Igorek3xd/-Sky-/3_Plata_fabrichna/Spisok_komponentov_BOM.csv

Reference | Value | Footprint | QUANTITY
C1,C2 | 4.7uF | Capacitor_SMD:C_0805_2012Metric | 2
C3,C4 | 10uF | Capacitor_SMD:C_0805_2012Metric | 2
C5,C8,C10 | 100nF | Capacitor_SMD:C_0603_1608Metric | 3
C6,C7 | 1uF | Capacitor_SMD:C_0603_1608Metric | 2
C9 | 10nF | Capacitor_SMD:C_0603_1608Metric | 1
D1 | SS14 | Diode_SMD:D_SMA | 1
D2 | CHG red | LED_SMD:LED_0603_1608Metric | 1
F1 | 500mA PTC | Fuse:Fuse_1206_3216Metric | 1
J1 | USB-C | Connector_USB:USB_C_Receptacle_HRO_TYPE-C-31-M-12 | 1
J2 | LiPo 1S 1000mAh | Connector_JST:JST_PH_S2B-PH-SM4-TB_1x02-1MP_P2.00mm_Horizontal | 1
J3 | OLED 0.96 SSD1306 | Connector_PinHeader_2.54mm:PinHeader_1x04_P2.54mm_Vertical | 1
Q1,Q2 | AO3401A | Package_TO_SOT_SMD:SOT-23 | 2
R1,R2 | 5.1k | Resistor_SMD:R_0603_1608Metric | 2
R3 | 4.7k (210mA) | Resistor_SMD:R_0603_1608Metric | 1
R4 | 1k | Resistor_SMD:R_0603_1608Metric | 1
R5,R10,R13,R16,R17 | 100k | Resistor_SMD:R_0603_1608Metric | 5
R6-R9 | 10k | Resistor_SMD:R_0603_1608Metric | 4
R11,R12 | 4.7k | Resistor_SMD:R_0603_1608Metric | 2
R14,R15 | 1M | Resistor_SMD:R_0603_1608Metric | 2
SW1 | WAKE (side) | Button_Switch_SMD:SW_SPST_EVQP7A | 1
SW2 | RESET | Button_Switch_SMD:SW_Push_SPST_NO_Alps_SKRK | 1
SW3 | BOOT | Button_Switch_SMD:SW_Push_SPST_NO_Alps_SKRK | 1
U1 | USBLC6-2SC6 | Package_TO_SOT_SMD:SOT-23-6 | 1
U2 | MCP73831-2-OT | Package_TO_SOT_SMD:SOT-23-5 | 1
U3 | ME6211C33M5 | Package_TO_SOT_SMD:SOT-23-5 | 1
U4 | ESP32-C3-WROOM-02 | RF_Module:ESP32-C3-WROOM-02 | 1
U5 | SHT40 | Sensor_Humidity:Sensirion_DFN-4_1.5x1.5mm_P0.8mm_SHT4x_NoCentralPad | 1
