Igorek3xd/-Sky-/1_Korpus_3D/ThermoBox_case_assembly.step

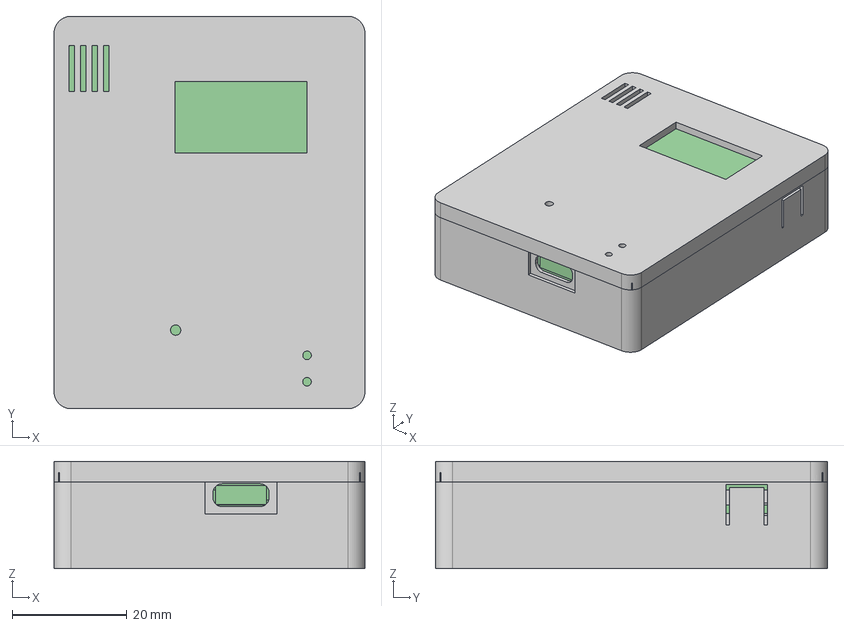
[picture p12: CAD file, 2026-11-13]
1_Korpus_3D/ThermoBox_case_assembly.step
54.2 x 68.4 x 18.7 mm
