Igorek3xd/-Sky-/1_Korpus_3D/ThermoBox_Base.stl

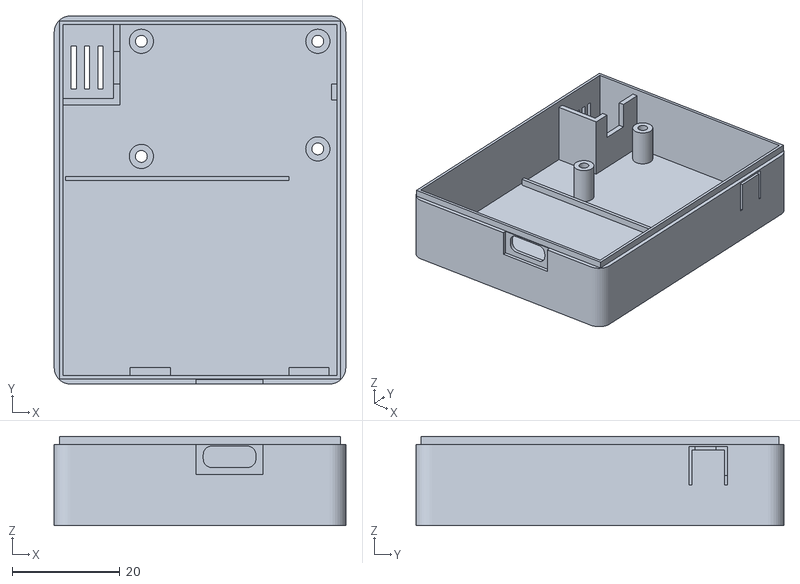
[picture p13: CAD file, 2026-11-13]
1_Korpus_3D/ThermoBox_Base.stl
54.2 x 68.4 x 16.6
