Igorek3xd/-Sky-/1_Korpus_3D/ThermoBox_Lid.stl

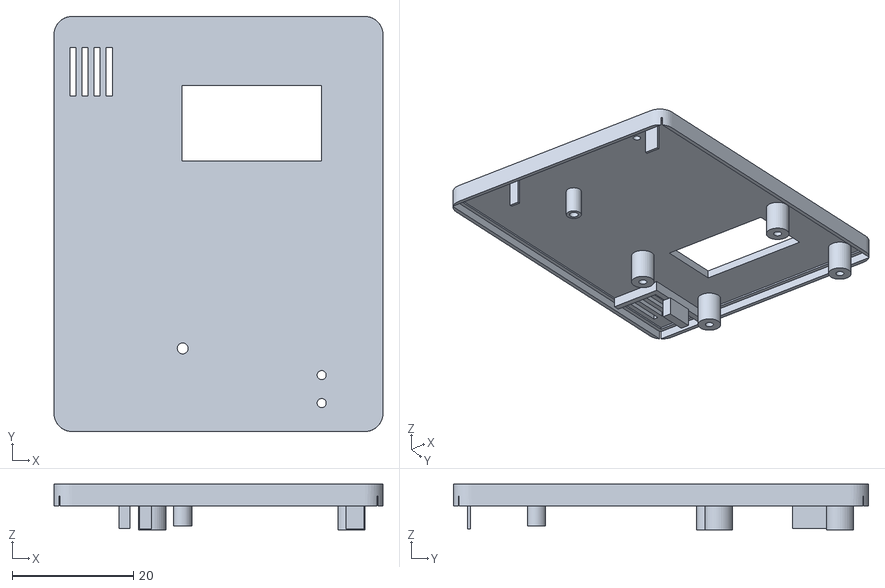
[picture p14: CAD file, 2026-11-13]
1_Korpus_3D/ThermoBox_Lid.stl
54.2 x 68.4 x 7.50
