Igorek3xd/-Sky-/1_Korpus_3D/ThermoBox_plata.step

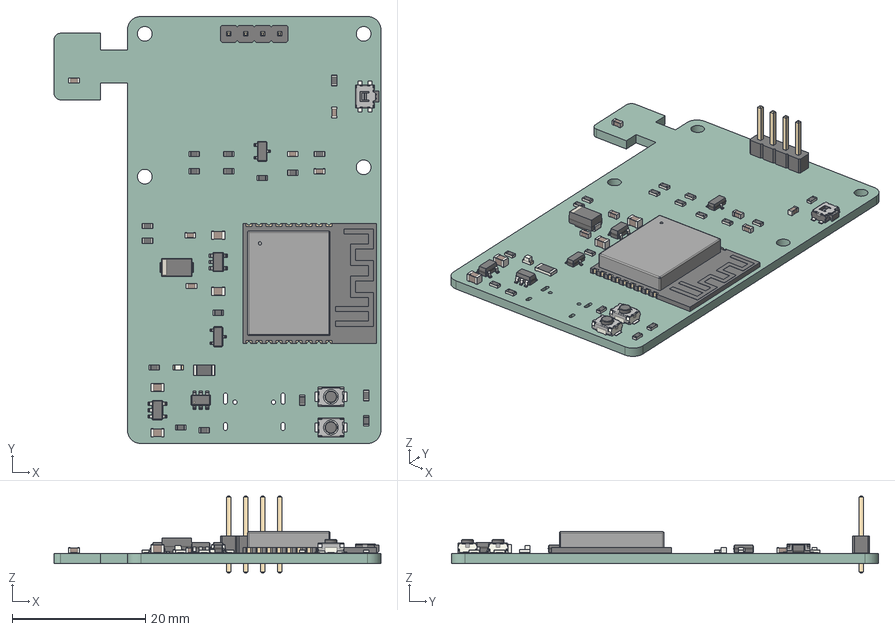
[picture p15: CAD file, 2026-11-13]
1_Korpus_3D/ThermoBox_plata.step
49.0 x 64.0 x 11.5 mm
R_0603_1608Metric x 17
C_0805_2012Metric x 4
C_0603_1608Metric x 6
PinHeader_1x04_P254mm_Vertical
SOT-23-6
SOT-23-5 x 2
Fuse_1206_3216Metric
D_SMA
LED_0603_1608Metric
ESP32-C3-WROOM-02
SW_Push_SPST_NO_Alps_SKRK x 2
SOT-23 x 2
SW_SPST_EVQP7A
ThermoBox_PCB
