Igorek3xd/-Sky-/(list of files, cad)

Other CAD files:
1_Korpus_3D/ThermoBox_case.f3d
