Igorek3xd/-Sky-/2_Skhema/Skhema_principialnaya.pdf

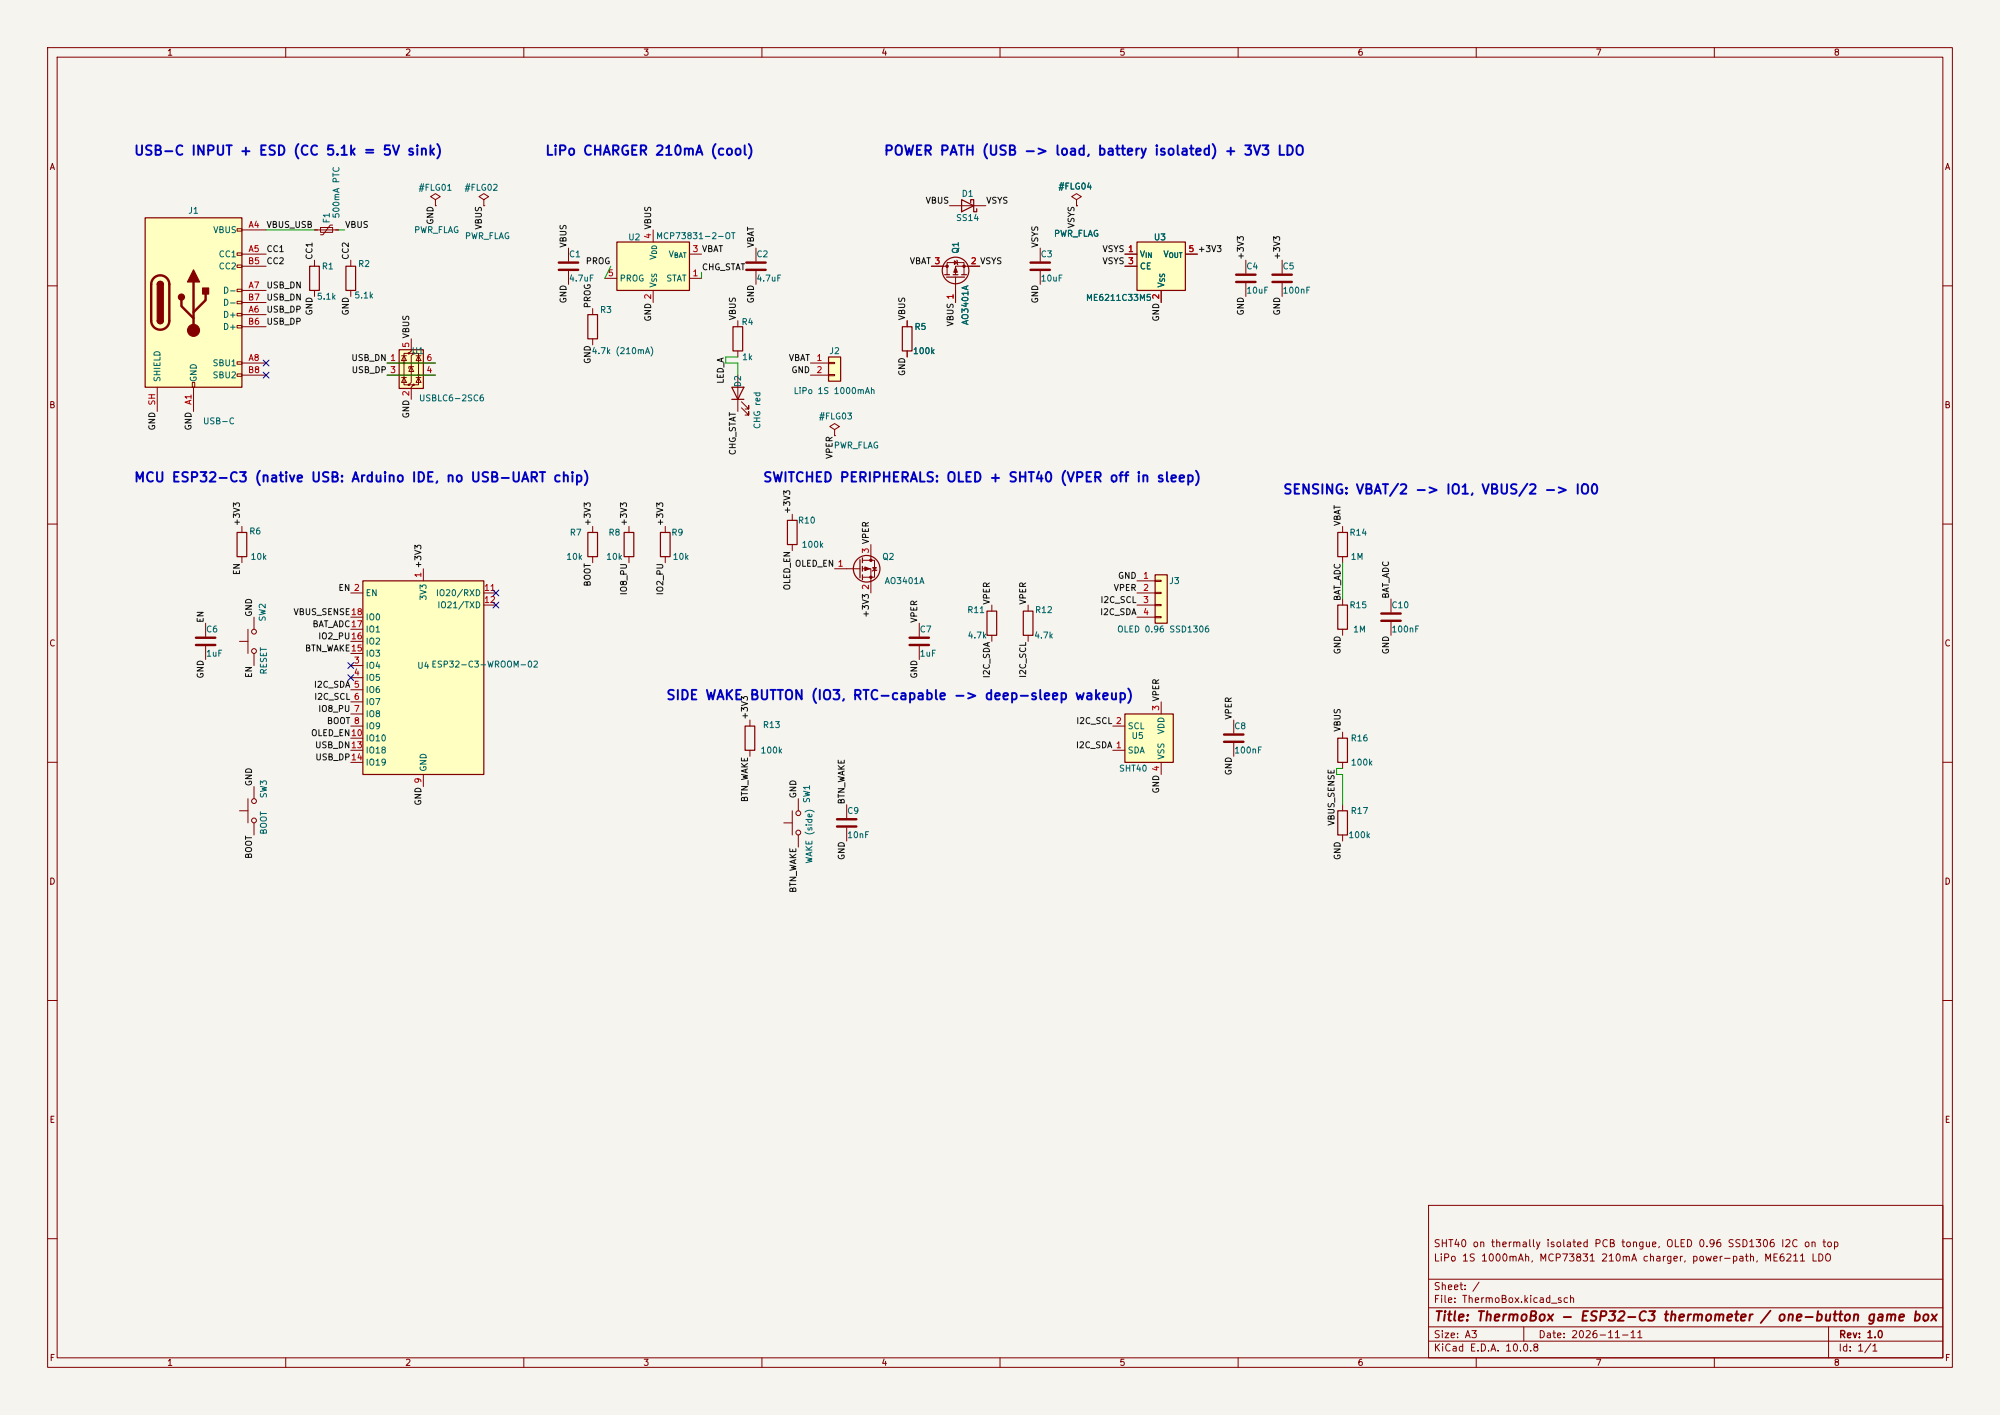
[picture p16: page 1]

SWITCHED PERIPHERALS: OLED + SHT40 (VPER off in sleep)

SIDE WAKE BUTTON (IO3, RTC-capable -> deep-sleep wakeup)

SHT40 on thermally isolated PCB tongue, OLED 0.96 SSD1306 I2C on top
LiPo 1S 1000mAh, MCP73831 210mA charger, power-path, ME6211 LDO

Sheet: /
File: ThermoBox.kicad_sch
Title: ThermoBox - ESP32-C3 thermometer / one-button game box

Size: A3 | Rev: 1.0 | F Date: 2026-11-11
KiCad E.D.A. 10.0.8 | Id: 1/1
