Igorek3xd/-Sky-/2_Skhema/KiCad_proekt/ThermoBox.kicad_pcb

## KiCad design 2_Skhema/KiCad_proekt/ThermoBox.kicad_pcb (2026-11-13)

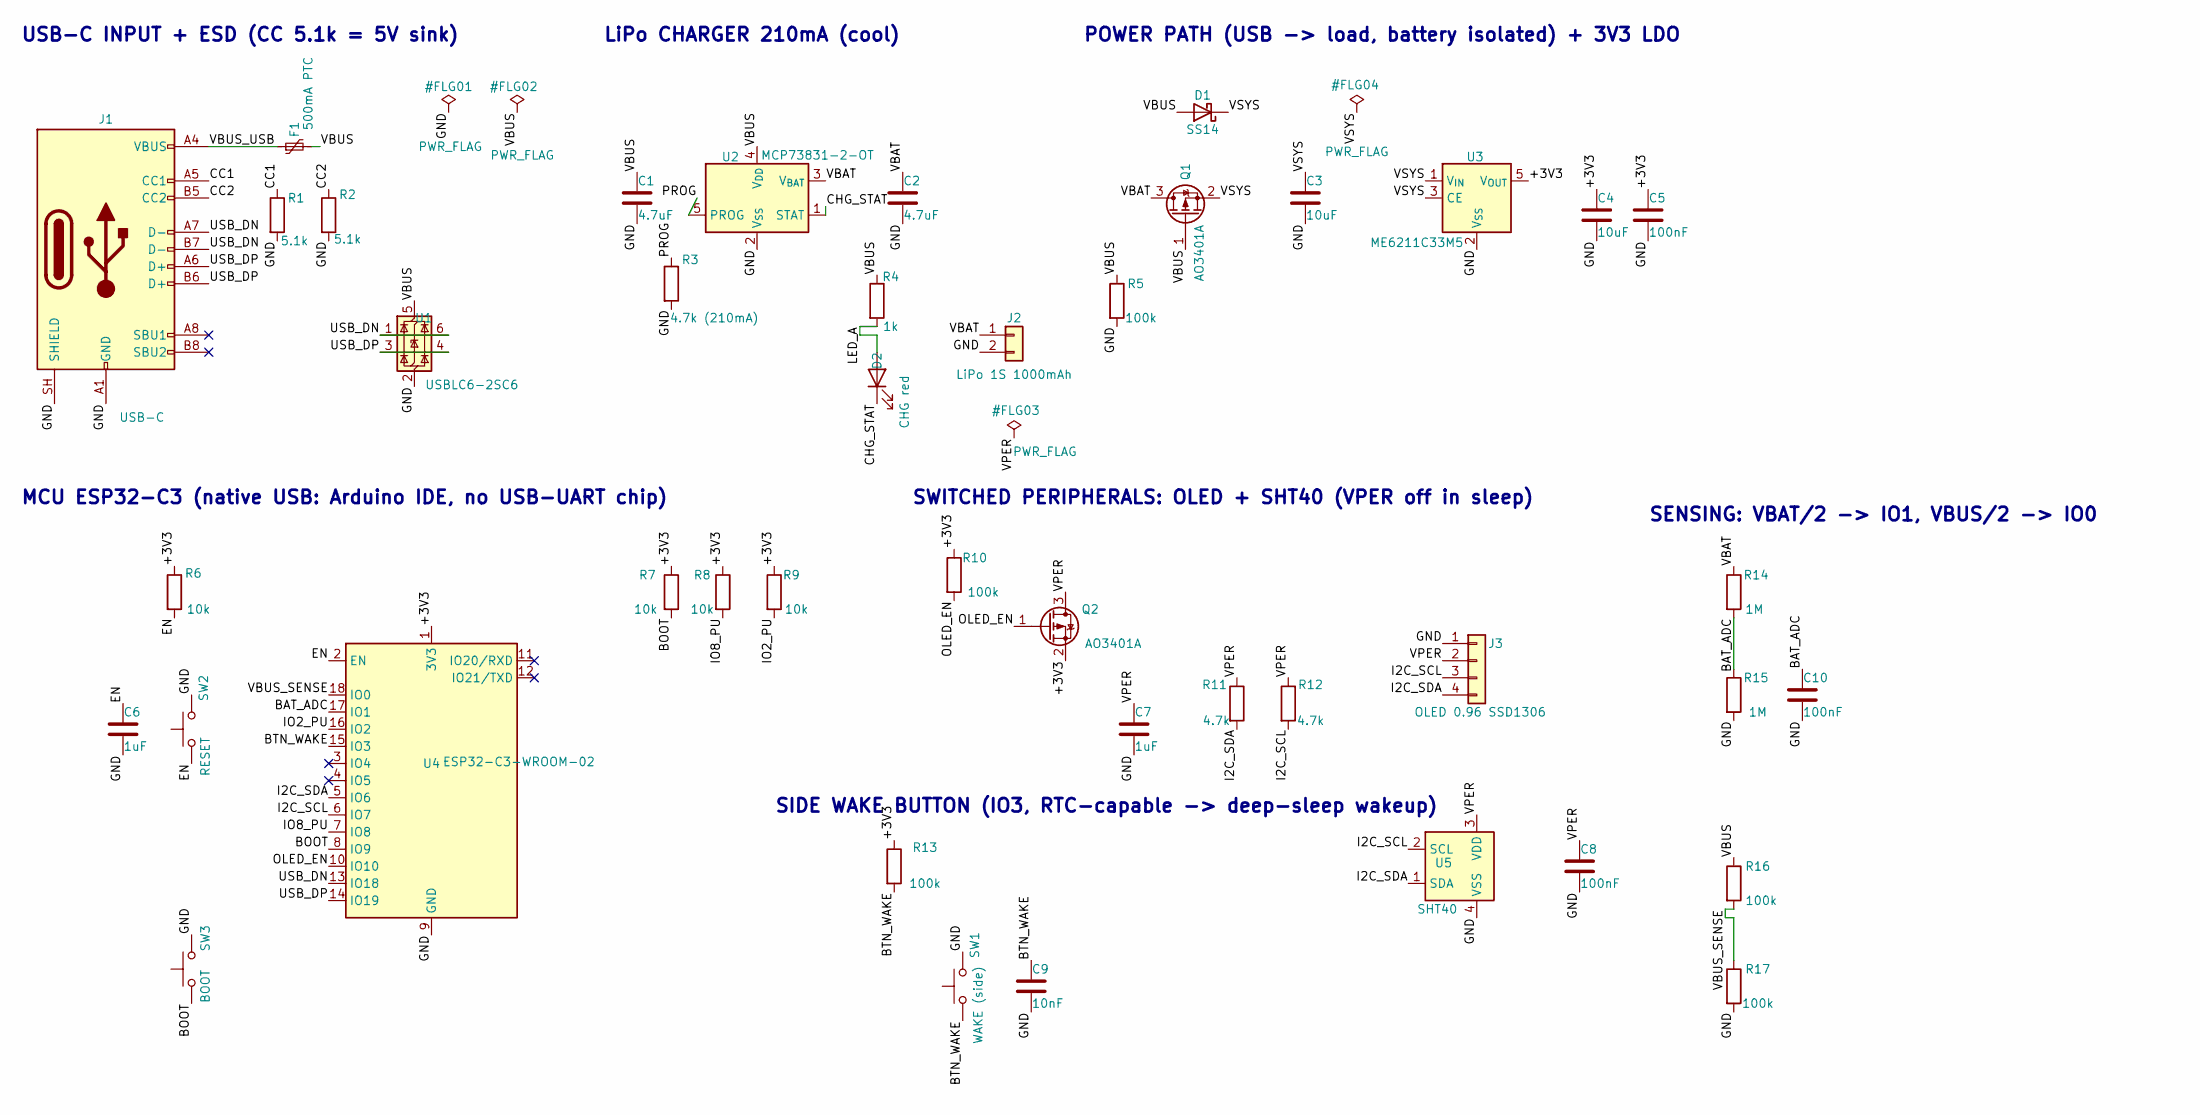
[picture p17: schematic ThermoBox.kicad_sch, ThermoBox - ESP32-C3 thermometer / one-button game box]

Parts:
C1, C2: 4.7uF; C_0805_2012Metric
C3, C4: 10uF; C_0805_2012Metric
C5, C8, C10: 100nF; C_0603_1608Metric
C6, C7: 1uF; C_0603_1608Metric
C9: 10nF; C_0603_1608Metric
D1: SS14; D_SMA
D2: CHG red; LED_0603_1608Metric
F1: 500mA PTC; Fuse_1206_3216Metric
J1: USB-C; USB_C_Receptacle_HRO_TYPE-C-31-M-12
J2: LiPo 1S 1000mAh; JST_PH_S2B-PH-SM4-TB_1x02-1MP_P2.00mm_Horizontal
J3: OLED 0.96 SSD1306; PinHeader_1x04_P2.54mm_Vertical
Q1, Q2: AO3401A; SOT-23
R1, R2: 5.1k; R_0603_1608Metric
R3: 4.7k (210mA); R_0603_1608Metric
R4: 1k; R_0603_1608Metric
R5, R10, R13, R16, R17: 100k; R_0603_1608Metric
R6, R7, R8, R9: 10k; R_0603_1608Metric
R11, R12: 4.7k; R_0603_1608Metric
R14, R15: 1M; R_0603_1608Metric
SW1: WAKE (side); SW_SPST_EVQP7A
SW2: RESET; SW_Push_SPST_NO_Alps_SKRK
SW3: BOOT; SW_Push_SPST_NO_Alps_SKRK
U1: USBLC6-2SC6; SOT-23-6
U2: MCP73831-2-OT; SOT-23-5
U3: ME6211C33M5; SOT-23-5
U4: ESP32-C3-WROOM-02
U5: SHT40; Sensirion_DFN-4_1.5x1.5mm_P0.8mm_SHT4x_NoCentralPad

Connections:
/+3V3: C4.1, C5.1, Q2.2 (S), R6.1, R7.1, R8.1, R9.1, R10.1, R13.1, U3.5 (V_{OUT}), U4.1 (3V3)
/BAT_ADC: C10.1, R14.2, R15.1, U4.17 (IO1)
/BOOT: R7.2, SW3.1, U4.8 (IO9)
/BTN_WAKE: C9.1, R13.2, SW1.1, U4.15 (IO3)
/CC1: J1.A5 (CC1), R1.1
/CC2: J1.B5 (CC2), R2.1
/CHG_STAT: D2.1 (K), U2.1 (STAT)
/EN: C6.1, R6.2, SW2.1, U4.2 (EN)
/GND: C1.2, C2.2, C3.2, C4.2, C5.2, C6.2, C7.2, C8.2, C9.2, C10.2, J1.A1 (GND), J1.A12 (GND), J1.B1 (GND), J1.B12 (GND), J1.SH (SHIELD), J2.2, J3.1, R1.2, R2.2, R3.2, R5.2, R15.2, R17.2, SW1.2, SW2.2, SW3.2, U1.2 (GND), U2.2 (V_{SS}), U3.2 (V_{SS}), U4.9 (GND), U4.19 (GND), U5.4 (VSS)
/I2C_SCL: J3.3, R12.2, U4.6 (IO7), U5.2 (SCL)
/I2C_SDA: J3.4, R11.2, U4.5 (IO6), U5.1 (SDA)
/IO2_PU: R9.2, U4.16 (IO2)
/IO8_PU: R8.2, U4.7 (IO8)
/LED_A: D2.2 (A), R4.2
/OLED_EN: Q2.1 (G), R10.2, U4.10 (IO10)
/PROG: R3.1, U2.5 (PROG)
/USB_DN: J1.A7 (D-), J1.B7 (D-), U1.1 (I/O1), U1.6 (I/O1), U4.13 (IO18)
/USB_DP: J1.A6 (D+), J1.B6 (D+), U1.3 (I/O2), U1.4 (I/O2), U4.14 (IO19)
/VBAT: C2.1, J2.1, Q1.3 (D), R14.1, U2.3 (V_{BAT})
/VBUS: C1.1, D1.2 (A), F1.2, Q1.1 (G), R4.1, R5.1, R16.1, U1.5 (VBUS), U2.4 (V_{DD})
/VBUS_SENSE: R16.2, R17.1, U4.18 (IO0)
/VBUS_USB: F1.1, J1.A4 (VBUS), J1.A9 (VBUS), J1.B4 (VBUS), J1.B9 (VBUS)
/VPER: C7.1, C8.1, J3.2, Q2.3 (D), R11.1, R12.1, U5.3 (VDD)
/VSYS: C3.1, D1.1 (K), Q1.2 (S), U3.1 (V_{IN}), U3.3 (CE)

Notes on the sheet:
POWER PATH (USB -> load, battery isolated) + 3V3 LDO
SWITCHED PERIPHERALS: OLED + SHT40 (VPER off in sleep)
LiPo CHARGER 210mA (cool)
MCU ESP32-C3 (native USB: Arduino IDE, no USB-UART chip)
SENSING: VBAT/2 -> IO1, VBUS/2 -> IO0
SIDE WAKE BUTTON (IO3, RTC-capable -> deep-sleep wakeup)
USB-C INPUT + ESD (CC 5.1k = 5V sink)

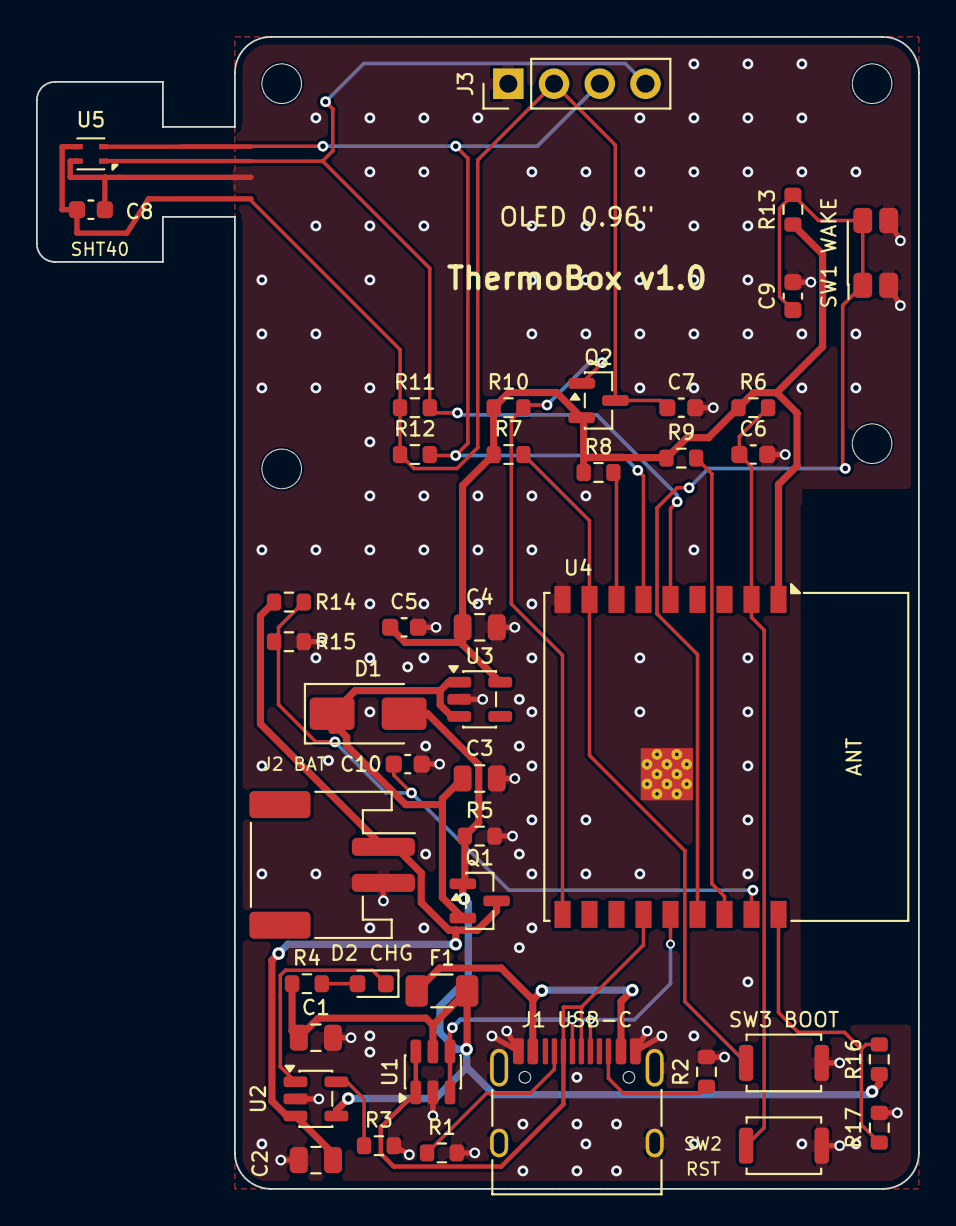
[picture p18: board ThermoBox.kicad_pcb from above]

Board: 2 copper layers, 49.0 x 64.0 mm, 47 parts (0 on the bottom side), 24 nets.

Other parts of the board:
H1, H2, H3, H4: MountingHole_2.2mm_M2
