Igorek3xd/-Sky-/(commit log)

2026-11-13 Update README to remove 3D preview instruction
    Removed instruction for interactive 3D preview on .stl files.
2026-11-13 Remove STEP assembly file link from README
    Removed assembly file link from the README.
